gerb-ster/MS20-VCF/images/IMG_3979.jpeg

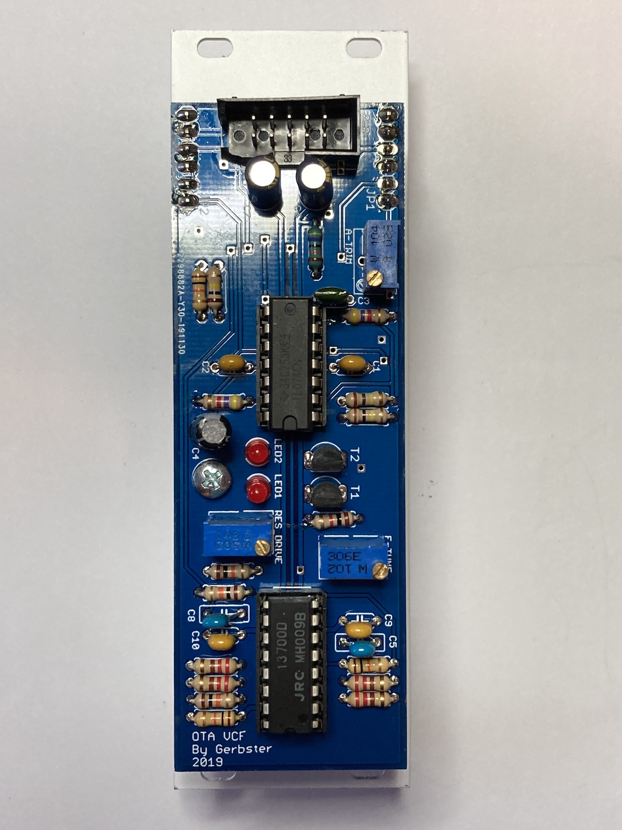
images/IMG_3979.jpeg
