gerb-ster/MS20-VCF/images/IMG_3994.jpeg

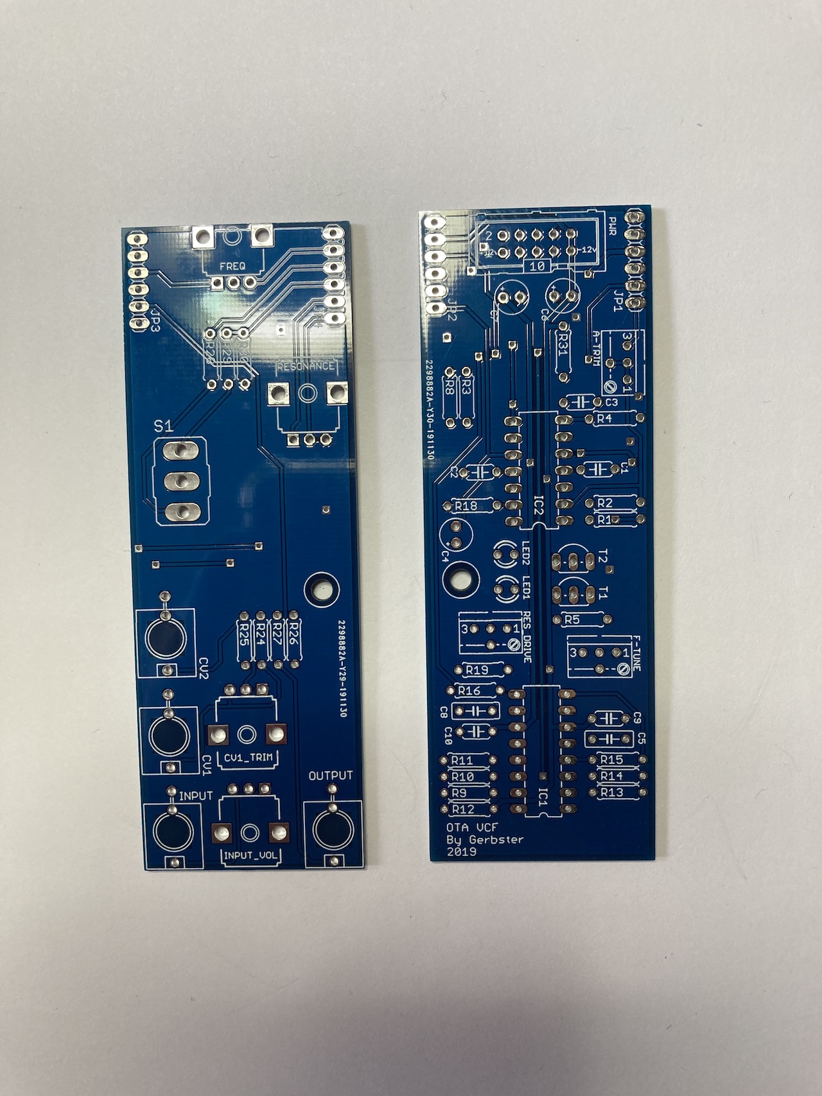
images/IMG_3994.jpeg
