gerb-ster/MS20-VCF/README.md

# Korg MS20 VCF

A(nother) eurorack adaptation of this classic Korg VCF from the MS20. 

## Status: Finished

- done: first schematic & board design
- done: breadboard and test
- done: design frontpanel
- done: order PCB and build prototype
