gerb-ster/MS20-VCF/images/IMG_3977.jpeg

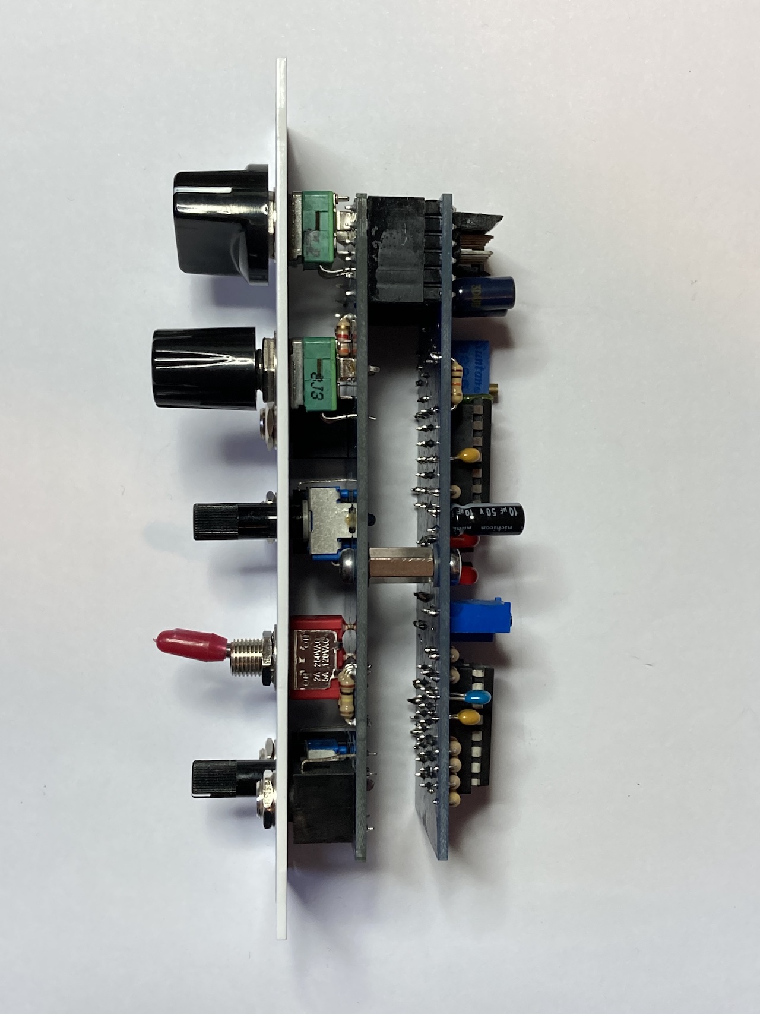
images/IMG_3977.jpeg
