gerb-ster/MS20-VCF/images/IMG_3978.jpeg

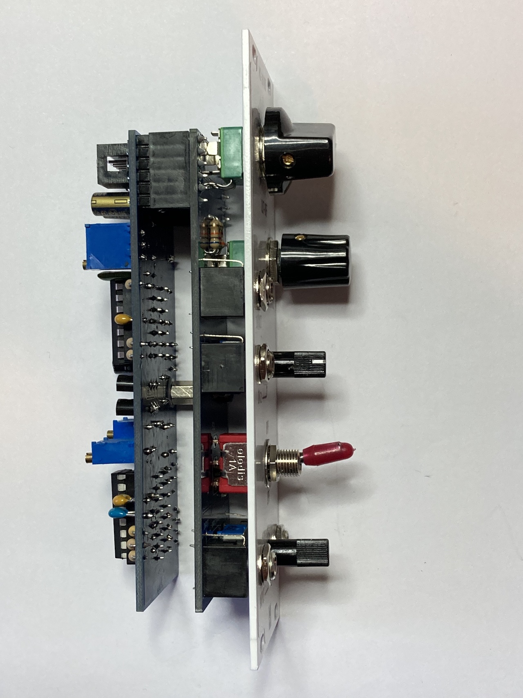
images/IMG_3978.jpeg
