gerb-ster/MS20-VCF/images/IMG_3980.jpeg

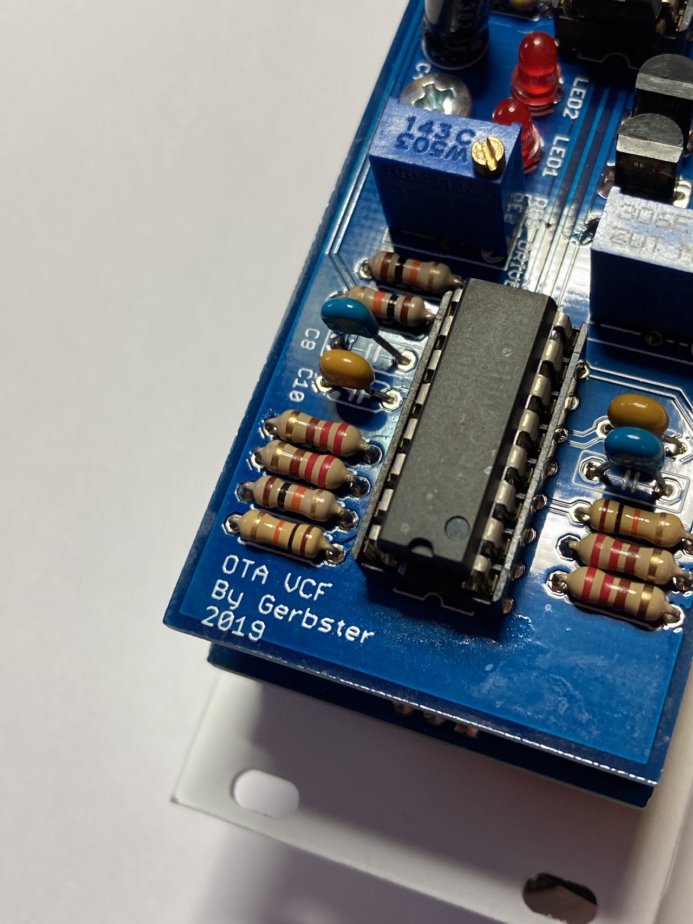
images/IMG_3980.jpeg
