gerb-ster/MS20-VCF/images/IMG_3981.jpeg

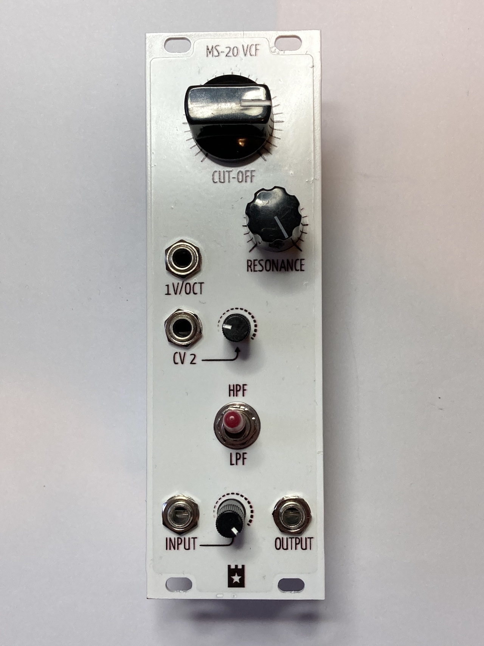
images/IMG_3981.jpeg
