gerb-ster/MS20-VCF/images/IMG_3995.jpeg

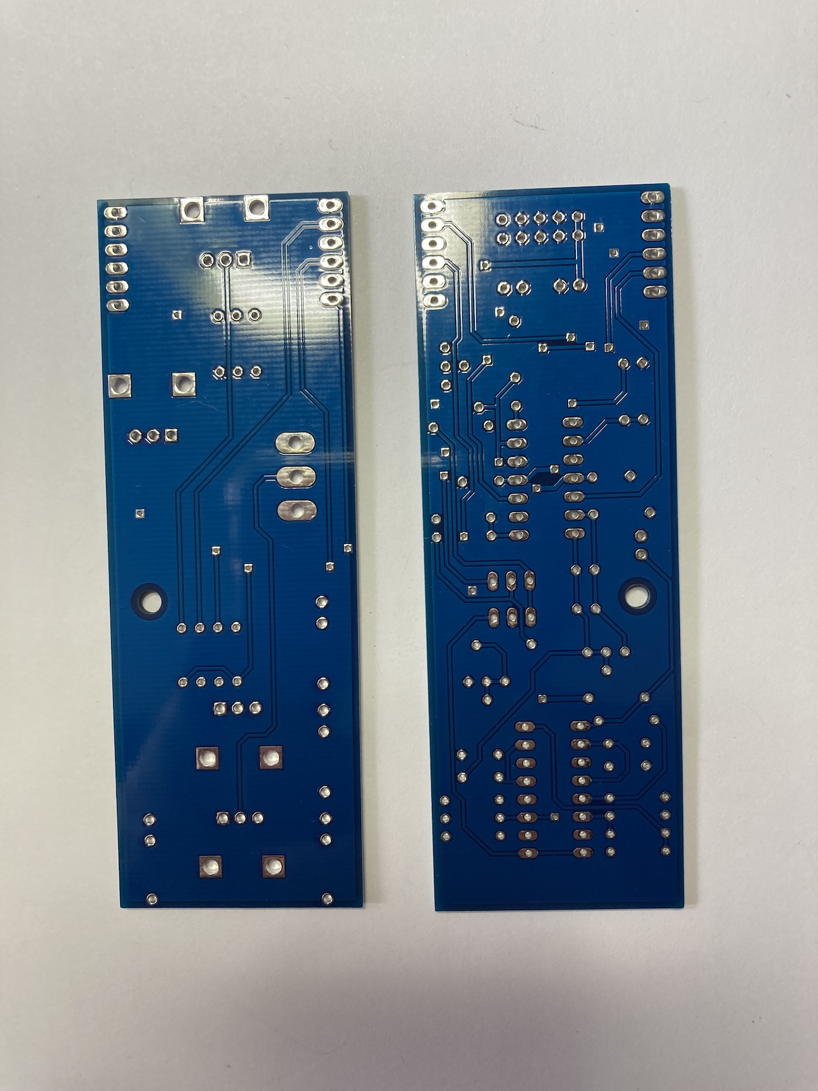
images/IMG_3995.jpeg
