gerb-ster/MS20-VCF/schematics/Korg-MS20-VCF-ioboard.png

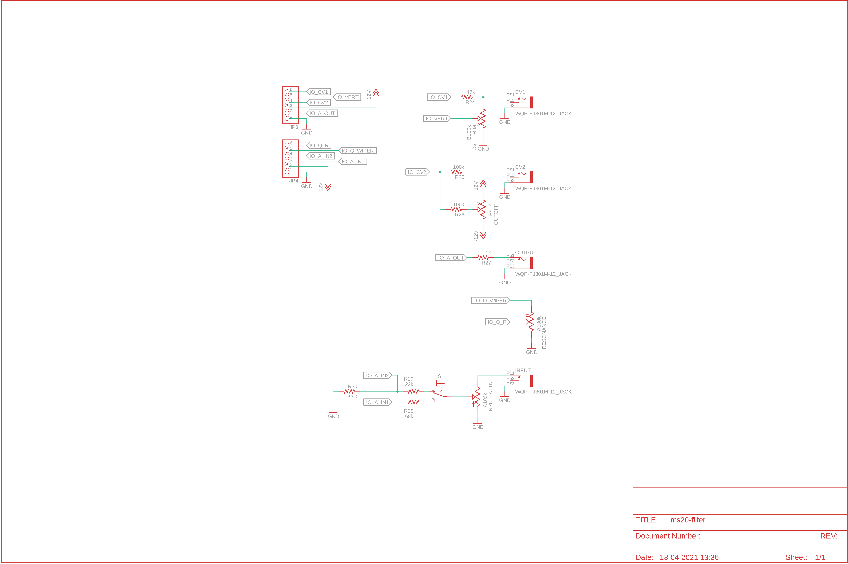
schematics/Korg-MS20-VCF-ioboard.png
