gerb-ster/MS20-VCF/schematics/Korg-MS20-VCF-mainboard.png

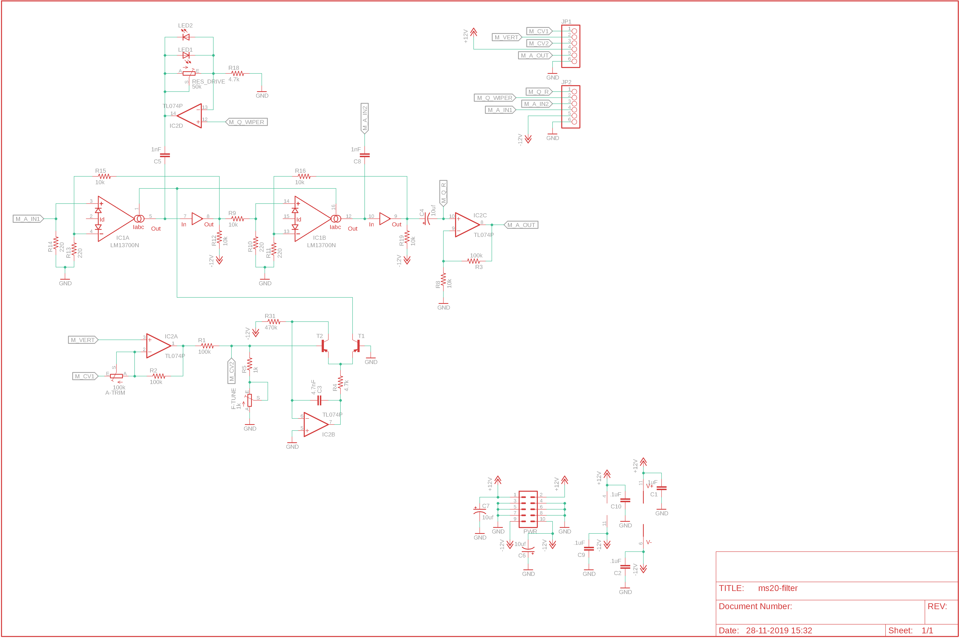
schematics/Korg-MS20-VCF-mainboard.png
