gerb-ster/MS20-VCF/faceplates/ms20-filter.dxf

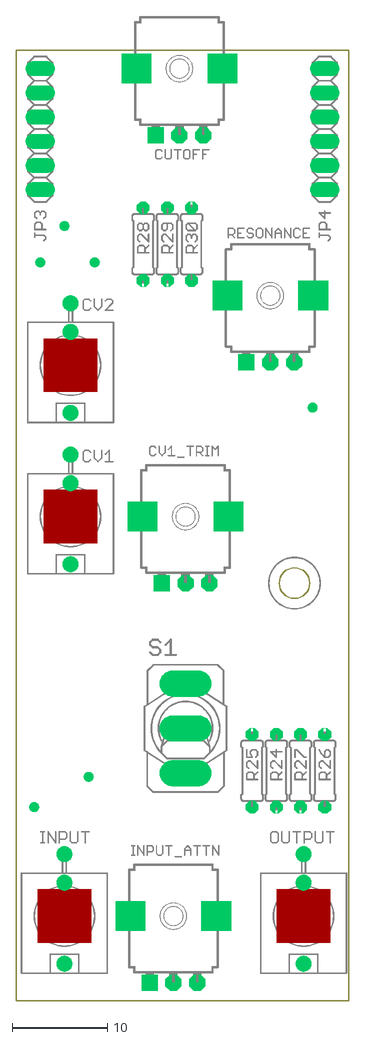
[picture p10: CAD file, 2021-05-10]
faceplates/ms20-filter.dxf
34.9 x 103.3
