gerb-ster/MS20-VCF/schematics/Korg-MS20-VCF-ioboard.pdf

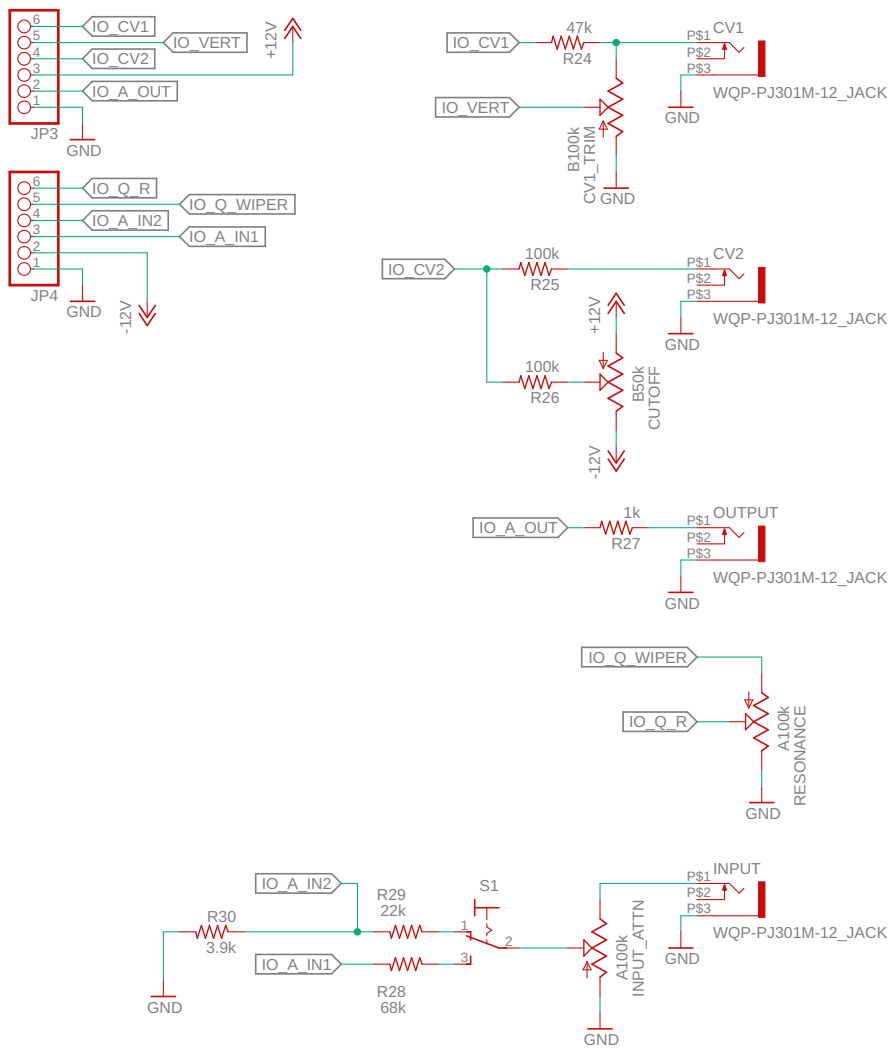
[picture p11: page 1]

Document Number: | REV:

Date: 10-05-2021 19:51 | Sheet: 1/1
