gerb-ster/MS20-VCF/schematics/Korg-MS20-VCF-mainboard.pdf

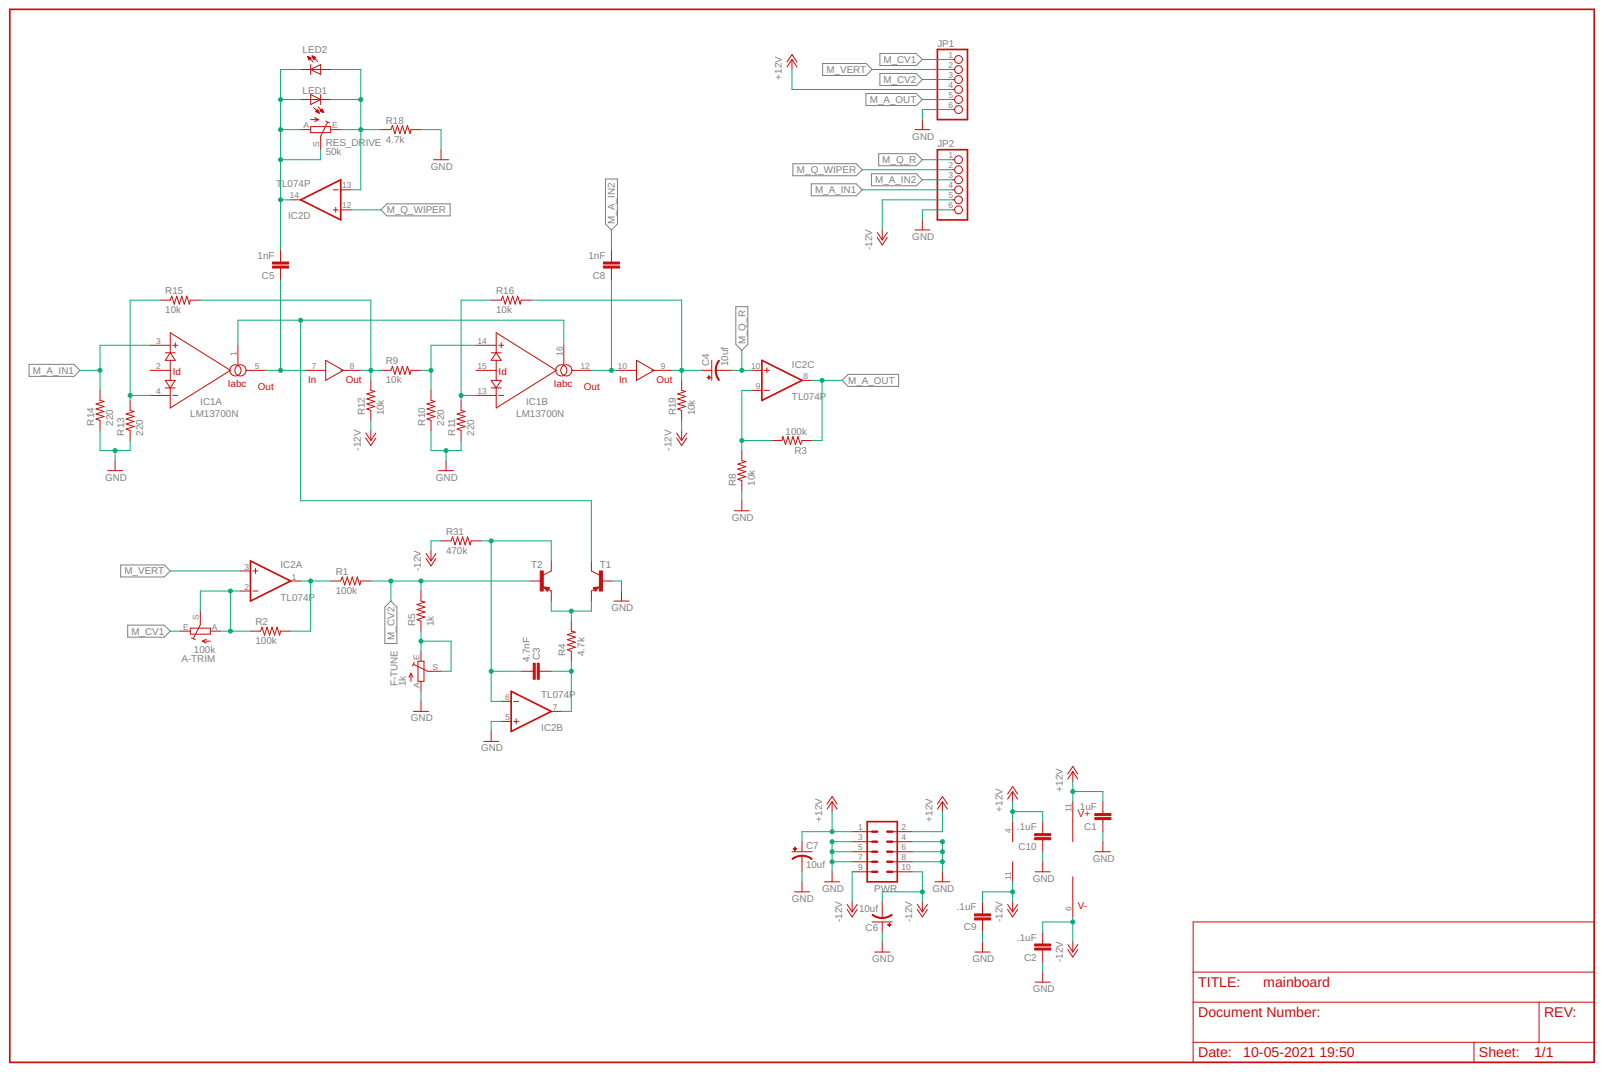
[picture p12: page 1]

Document Number: | REV:

Date: 10-05-2021 19:50 | Sheet: 1/1
