gerb-ster/MS20-VCF/schematics/src/ioboard/ioboard.brd

## EAGLE design schematics/src/ioboard/ioboard.brd (2021-05-10)

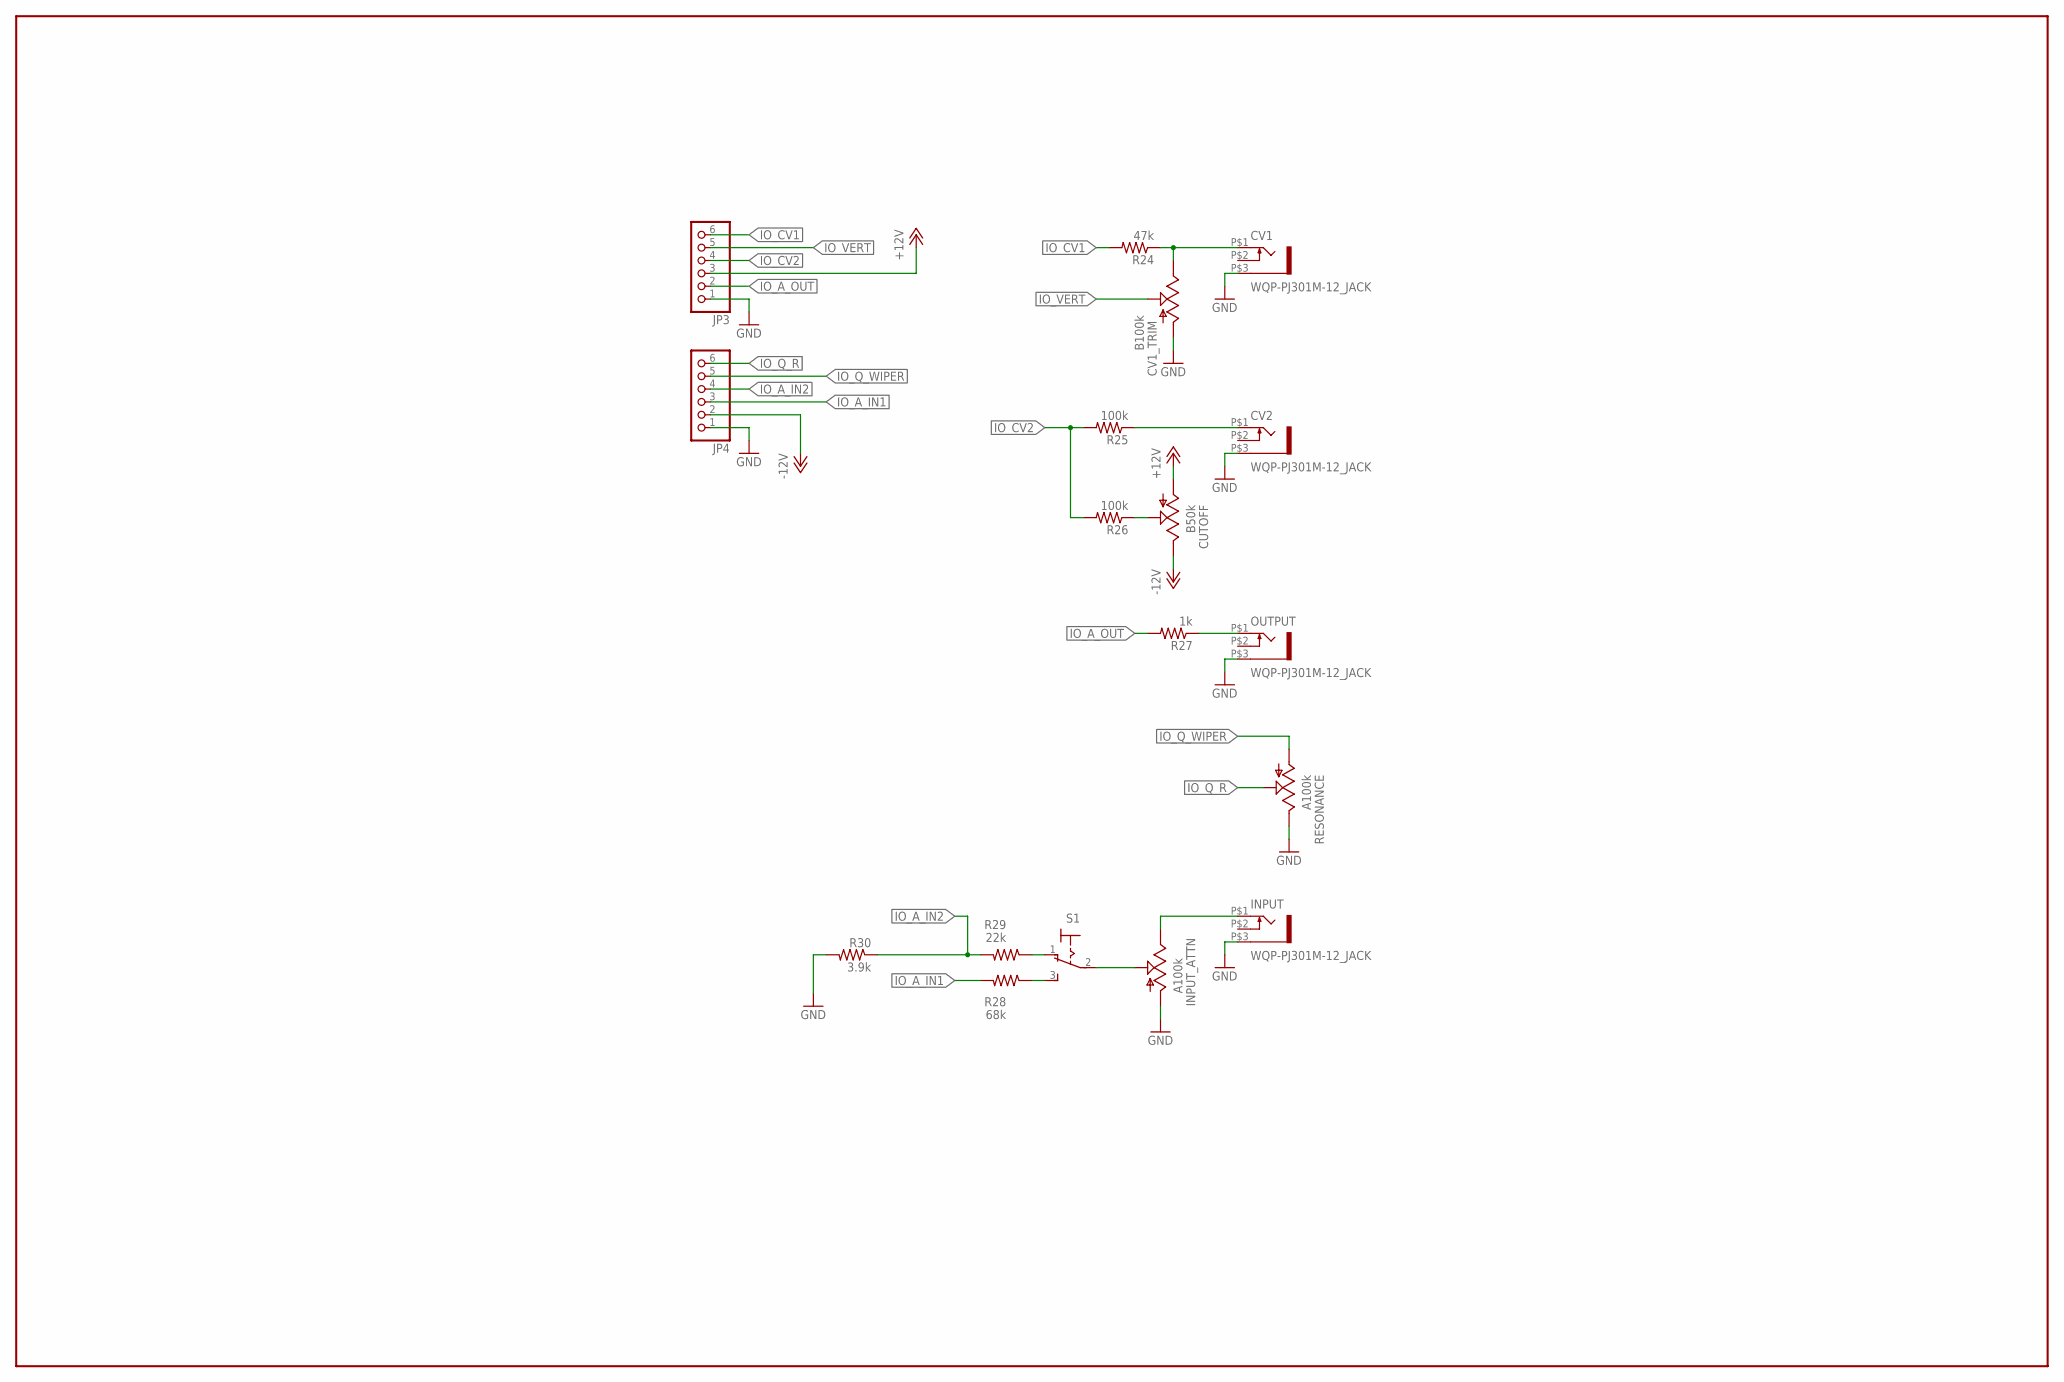
[picture p13: schematic ioboard.sch]

Parts:
CUTOFF: B50k; EVUF
CV1, CV2: WQP-PJ301M-12_JACK
CV1_TRIM: B100k; EVUF
INPUT: WQP-PJ301M-12_JACK
INPUT_ATTN: A100k; EVUF
JP3, JP4: PINHD-1X6; 1X06
OUTPUT: WQP-PJ301M-12_JACK
R24: 47k; 0207/7
R25, R26: 100k; 0207/7
R27: 1k; 0207/7
R28: 68k; 0207/7
R29: 22k; 0207/7
R30: 3.9k; 0207/7
RESONANCE: A100k; EVUF
S1: M9040P

Connections:
+12V: CUTOFF.1 (A), JP3.3
-12V: CUTOFF.3 (E), JP4.2
GND: CV1.P$3 (1), CV1_TRIM.1 (A), CV2.P$3 (1), INPUT.P$3 (1), INPUT_ATTN.1 (A), JP3.1, JP4.1, OUTPUT.P$3 (1), R30.2, RESONANCE.3 (E)
IO_A_IN1: JP4.3, R28.2
IO_A_IN2: JP4.4, R29.2, R30.1
IO_A_OUT: JP3.2, R27.2
IO_CV1: JP3.6, R24.2
IO_CV2: JP3.4, R25.2, R26.2
IO_Q_R: JP4.6, RESONANCE.2 (S)
IO_Q_WIPER: JP4.5, RESONANCE.1 (A)
IO_VERT: CV1_TRIM.2 (S), JP3.5
unnamed: CV2.P$1 (2), R25.1
unnamed: INPUT_ATTN.2 (S), S1.2
unnamed: CV1.P$1 (2), CV1_TRIM.3 (E), R24.1
unnamed: OUTPUT.P$1 (2), R27.1
unnamed: CUTOFF.2 (S), R26.1
unnamed: R29.1, S1.1 (O)
unnamed: R28.1, S1.3 (S)
unnamed: INPUT.P$1 (2), INPUT_ATTN.3 (E)

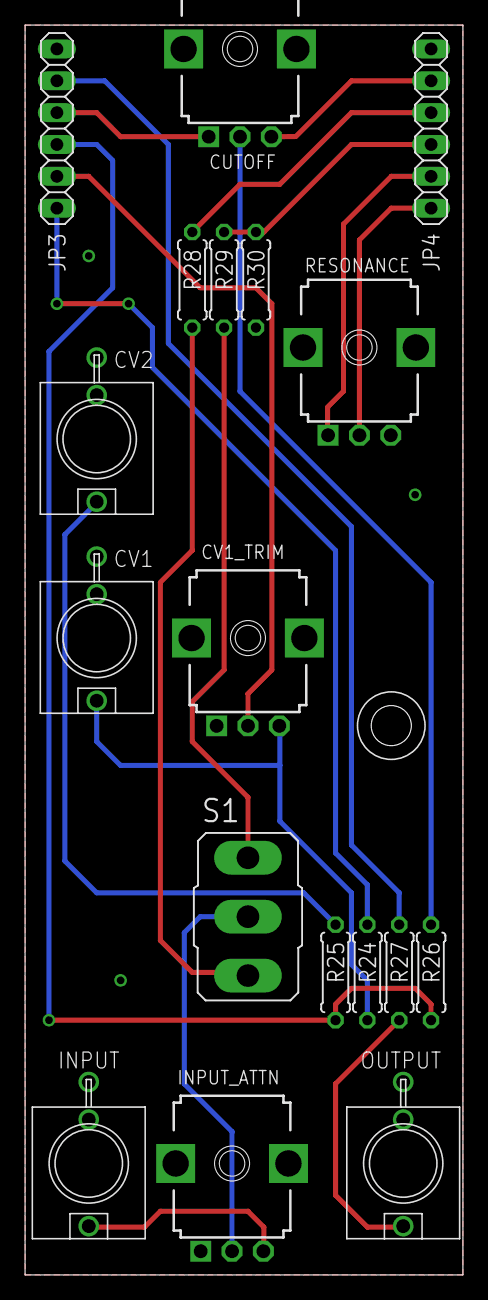
[picture p14: board ioboard.brd from above]

Board: 2 copper layers, 34.9 x 99.7 mm, 18 parts (0 on the bottom side), 19 nets.
