gerb-ster/MS20-VCF/schematics/src/mainboard/mainboard.brd

## EAGLE design schematics/src/mainboard/mainboard.brd (2021-05-10)

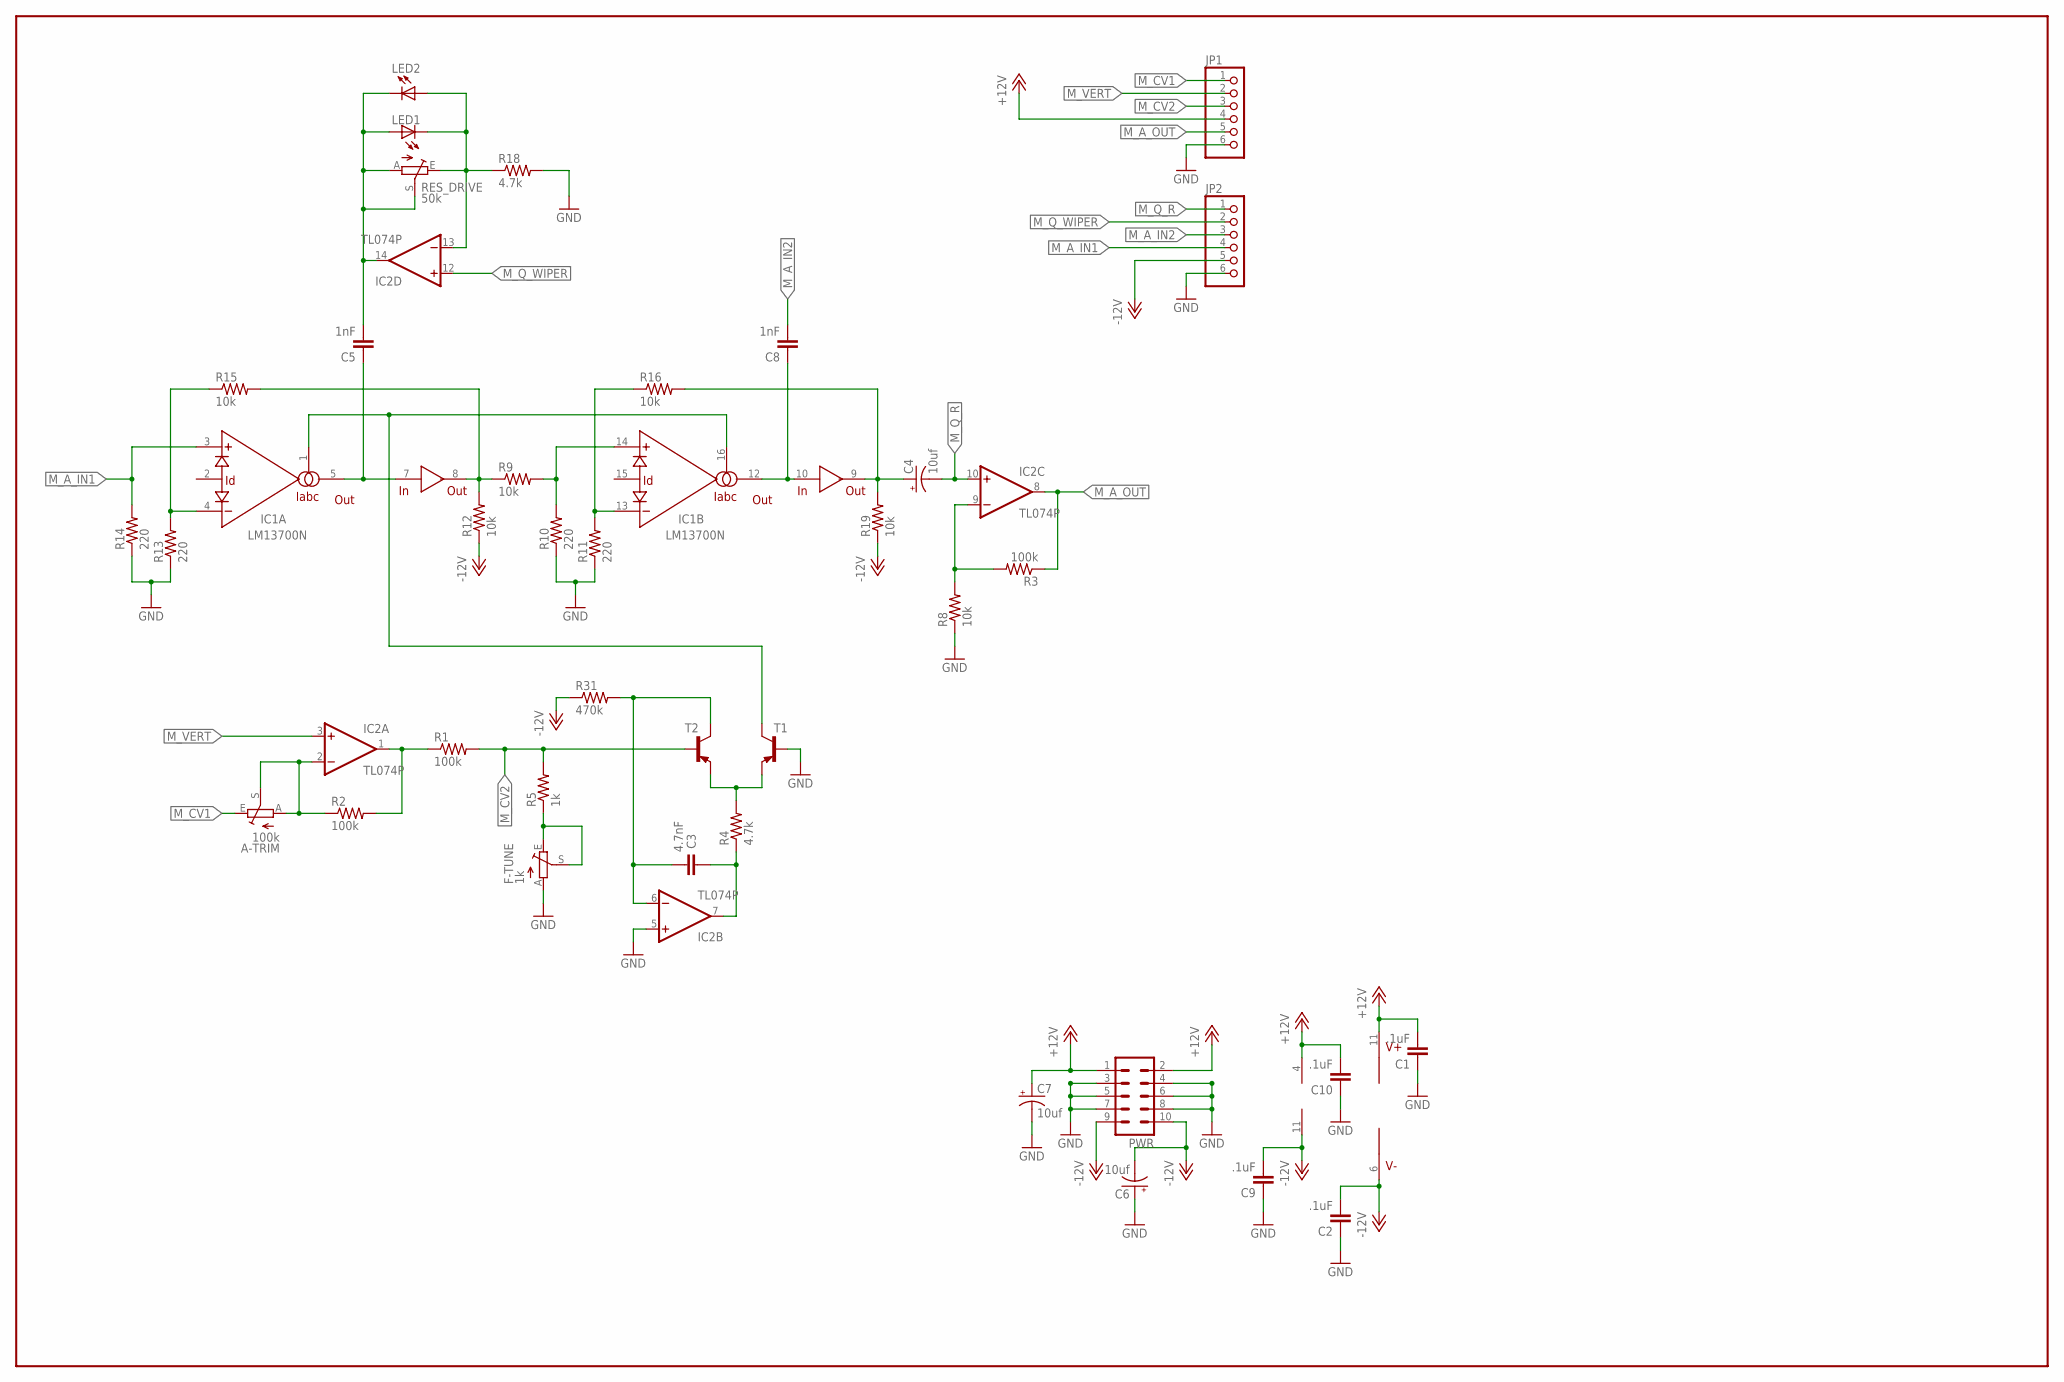
[picture p15: schematic mainboard.sch]

Parts:
A-TRIM: 100k; S64YW
C1, C2, C9, C10: .1uF; C050-024X044
C3: 4.7nF; C050-024X044
C4, C6, C7: 10uf; E2,5-5
C5, C8: 1nF; C050-025X075
F-TUNE: 1k; S64YW
IC1: LM13700N; DIL16
IC2: TL074P; DIL14
JP1, JP2: PINHD-1X6; 1X06
LED1, LED2: LED3MM
PWR: ML10
R1, R2, R3: 100k; 0207/7
R4, R18: 4.7k; 0207/7
R5: 1k; 0207/7
R8, R9, R12, R15, R16, R19: 10k; 0207/7
R10, R11, R13, R14: 220; 0207/7
R31: 470k; 0207/7
RES_DRIVE: 50k; S64YW
T1, T2: 2N3906-PNP-TO92-EBC; TO92-EBC

Connections:
+12V: C1.2, C7.+, C10.2, IC1.11 (V+), IC2.4 (V+), JP1.4, PWR.1, PWR.2
-12V: C2.2, C6.-, C9.2, IC1.6 (V-), IC2.11 (V-), JP2.5, PWR.9, PWR.10, R12.1, R19.1, R31.1
GND: C1.1, C2.1, C6.+, C7.-, C9.1, C10.1, F-TUNE.A, IC2.5 (+IN), JP1.6, JP2.6, PWR.3, PWR.4, PWR.5, PWR.6, PWR.7, PWR.8, R8.1, R10.1, R11.1, R13.1, R14.1, R18.2, T1.B
M_A_IN1: IC1.3 (+IN), JP2.4, R14.2
M_A_IN2: C8.2, JP2.3
M_A_OUT: IC2.8 (OUT), JP1.5, R3.1
M_CV1: A-TRIM.E, JP1.1
M_CV2: JP1.3, R1.2, R5.2, T2.B
M_Q_R: C4.-, IC2.10 (+IN), JP2.1
M_Q_WIPER: IC2.12 (+IN), JP2.2
M_VERT: IC2.3 (+IN), JP1.2
unnamed: IC2.1 (OUT), R1.1, R2.2
unnamed: R4.2, T1.E, T2.E
unnamed: A-TRIM.A, A-TRIM.S, IC2.2 (-IN), R2.1
unnamed: C3.1, IC2.7 (OUT), R4.1
unnamed: C5.2, IC2.14 (OUT), LED1.A, LED2.K (C), RES_DRIVE.A, RES_DRIVE.S
unnamed: IC1.4 (-IN), R13.2, R15.1
unnamed: IC1.14 (+IN), R9.2, R10.2
unnamed: IC2.9 (-IN), R3.2, R8.2
unnamed: C8.1, IC1.10 (IN), IC1.12 (OUT)
unnamed: C4.+, IC1.9 (OUT), R16.2, R19.2
unnamed: IC1.13 (-IN), R11.2, R16.1
unnamed: IC2.13 (-IN), LED1.K (C), LED2.A, R18.1, RES_DRIVE.E
unnamed: C5.1, IC1.5 (OUT), IC1.7 (IN)
unnamed: IC1.1 (IABC), IC1.16 (IABC), T1.C
unnamed: F-TUNE.E, F-TUNE.S, R5.1
unnamed: IC1.8 (OUT), R9.1, R12.2, R15.2
unnamed: C3.2, IC2.6 (-IN), R31.2, T2.C

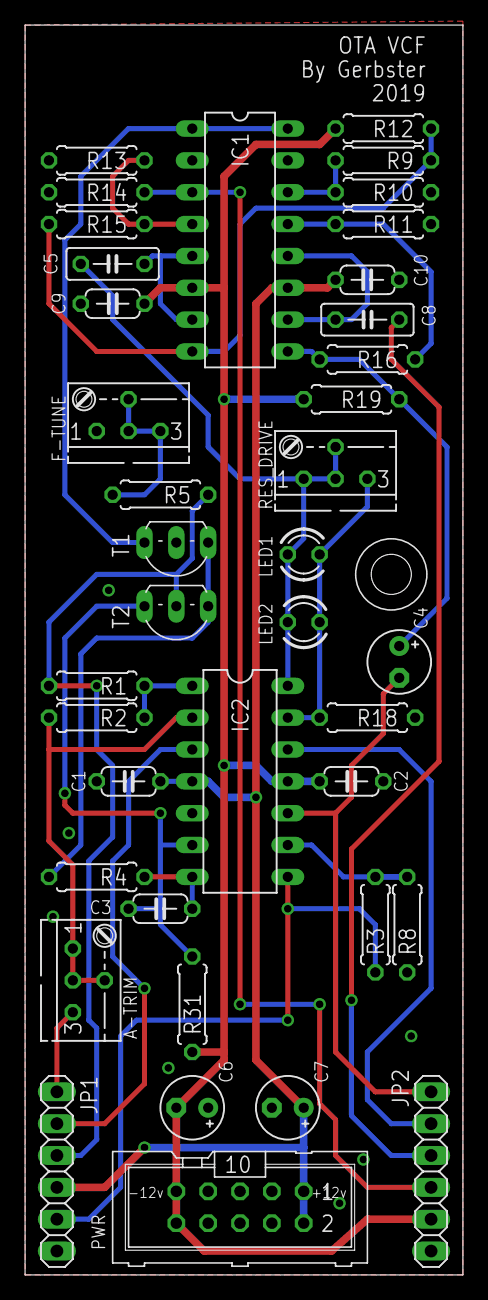
[picture p16: board mainboard.brd from above]

Board: 2 copper layers, 34.9 x 99.7 mm, 39 parts (0 on the bottom side), 28 nets.
