gerb-ster/MS20-VCF/(threads)

Thread 3 (2022-04-18):

The labels on the schematic for the resonance pot are wrong

gerb-ster, 2022-04-18:
the wiper and and the R labels are switched around

Thread 4 (2025-05-31):

Questions about PCB Adjustments and Panel Silkscreen

Sebastsch, 2025-05-31:
Hi, thank you very much for all the work you’ve done. I’ve had several of your PCBs made. I would like to know how to adjust the trimmer potentiometers, including on the Steiner as well, and also if the panel silkscreen has been corrected ?

Sincerely,
Sébastien
