gerb-ster/MS20-VCF/(commit log)

2021-05-10 Added files & structure
    [Korg-MS20-VCF-ioboard.GBL, Korg-MS20-VCF-ioboard.GBO, Korg-MS20-VCF-ioboard.GBP, Korg-MS20-VCF-ioboard.GBS, Korg-MS20-VCF-ioboard.GKO, Korg-MS20-VCF-ioboard.GTL, Korg-MS20-VCF-ioboard.GTO, Korg-MS20-VCF-ioboard.GTP]
2021-08-06 Updated some schematics and docs
    [Korg-MS20-VCF-ioboard.GBL, Korg-MS20-VCF-ioboard.GBO, Korg-MS20-VCF-ioboard.GBP, Korg-MS20-VCF-ioboard.GBS, Korg-MS20-VCF-ioboard.GKO, Korg-MS20-VCF-ioboard.GTL, Korg-MS20-VCF-ioboard.GTO, Korg-MS20-VCF-ioboard.GTP]
2021-08-10 Fixed some bugs and updated documentation
    [Korg-MS20-VCF-ioboard.XLN, Korg-MS20-VCF-mainboard.XLN, gerber_job.gbrjob]
2022-04-20 Some updates & bugfixes
    [Korg-MS20-VCF-ioboard.XLN, Korg-MS20-VCF-mainboard.XLN, gerber_job.gbrjob]
2022-04-22 Fixed schematics & descriptions
    [Korg-MS20-VCF-ioboard.XLN, Korg-MS20-VCF-mainboard.XLN, gerber_job.gbrjob]
2022-05-17 Updated Firmware
    [Korg-MS20-VCF-ioboard.XLN, Korg-MS20-VCF-mainboard.XLN, gerber_job.gbrjob]
2022-05-18 Updated Faceplates
    [Korg-MS20-VCF-ioboard.XLN, Korg-MS20-VCF-mainboard.XLN, gerber_job.gbrjob]
2022-05-18 Fixed issues
    [Korg-MS20-VCF-ioboard.XLN, Korg-MS20-VCF-mainboard.XLN, gerber_job.gbrjob]
2022-05-21 Fixed schematics
    [Korg-MS20-VCF-ioboard.XLN, Korg-MS20-VCF-mainboard.XLN, gerber_job.gbrjob]
2022-05-28 General updates
    [Korg-MS20-VCF-ioboard.GKO, Korg-MS20-VCF-mainboard.GKO, copper_bottom.gbr, copper_top.gbr, drills.xln, gerber_job.gbrjob, profile.gbr, silkscreen_bottom.gbr]
